savob/data_loading/README.md

# data_loading
Board inspired by the DATA album
