savob/data_loading/hardware/SJ-3523-SMT-TR.step

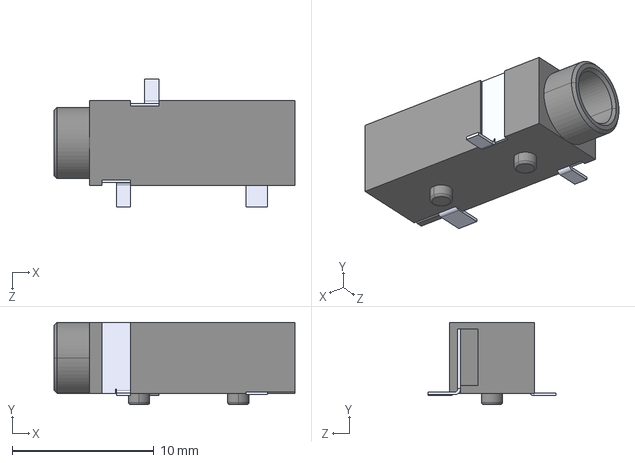
[picture p1: CAD file, 2024-02-17]
hardware/SJ-3523-SMT-TR.step
17.0 x 5.80 x 9.00 mm
