savob/data_loading/hardware/data_rev0/data_rev0.kicad_pcb

## KiCad design hardware/data_rev0/data_rev0.kicad_pcb (2024-03-04, an earlier design)

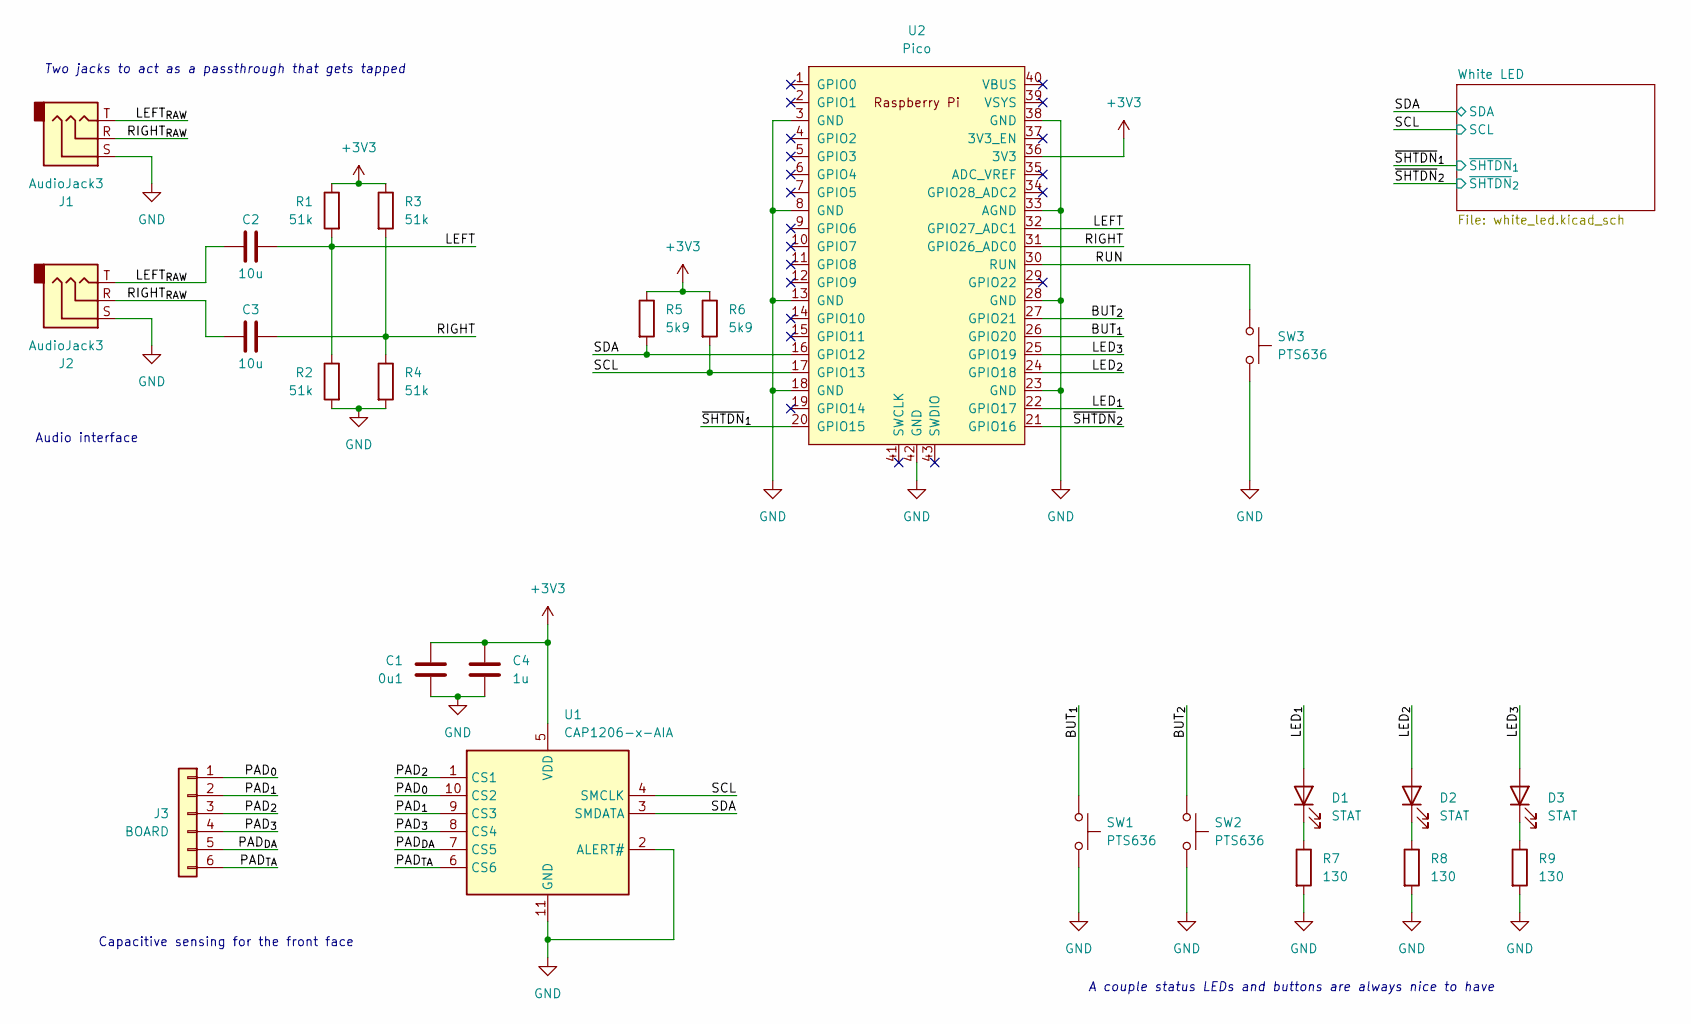
[picture p2: schematic data_rev0.kicad_sch, DATA Loading]

Parts:
C1: 0u1; C_0603_1608Metric
C2, C3: 10u; C_0805_2012Metric
C4: 1u; C_0603_1608Metric
D1, D2, D3: STAT; LED_0805_2012Metric
J1, J2: AudioJack3; Jack_3.5mm_CUI_SJ-3523-SMT_Horizontal
J3: BOARD; fill
R1, R2, R3, R4: 51k; R_0603_1608Metric
R5, R6: 5k9; R_0603_1608Metric
R7, R8, R9: 130; R_0603_1608Metric
SW1, SW2, SW3: PTS636; SW_SPST_CK_RS282G05A3
U1: CAP1206-x-AIA; DFN-10-1EP_3x3mm_P0.5mm_EP1.55x2.48mm
U2: Pico; RPi_Pico_SMD

Connections:
+3V3: C1.1, C4.2, R1.1, R3.1, R5.1, R6.1, U1.5 (VDD), U2.36 (3V3); also elsewhere on the board
/BUT_{1}: SW1.1, U2.26 (GPIO20)
/BUT_{2}: SW2.1, U2.27 (GPIO21)
/LED_{1}: D1.2 (A), U2.22 (GPIO17)
/LED_{2}: D2.2 (A), U2.24 (GPIO18)
/LED_{3}: D3.2 (A), U2.25 (GPIO19)
/LEFT: C2.1, R1.2, R2.1, U2.32 (GPIO27_ADC1)
/LEFT_{RAW}: C2.2, J1.T, J2.T
/PAD_{0}: J3.1, U1.10 (CS2)
/PAD_{1}: J3.2, U1.9 (CS3)
/PAD_{2}: J3.3, U1.1 (CS1)
/PAD_{3}: J3.4, U1.8 (CS4)
/PAD_{DA}: J3.5, U1.7 (CS5)
/PAD_{TA}: J3.6, U1.6 (CS6)
/RIGHT: C3.1, R3.2, R4.1, U2.31 (GPIO26_ADC0)
/RIGHT_{RAW}: C3.2, J1.R, J2.R
/RUN: SW3.1, U2.30 (RUN)
/SCL: R6.2, U1.4 (SMCLK), U2.17 (GPIO13); also elsewhere on the board
/SDA: R5.2, U1.3 (SMDATA), U2.16 (GPIO12); also elsewhere on the board
/~SHTDN_{1}: U2.20 (GPIO15); also elsewhere on the board
/~SHTDN_{2}: U2.21 (GPIO16); also elsewhere on the board
GND: C1.2, C4.1, J1.S, J2.S, R2.2, R4.2, R7.2, R8.2, R9.2, SW1.2, SW2.2, SW3.2, U1.2 (ALERT#), U1.11 (GND), U2.3 (GND), U2.8 (GND), U2.13 (GND), U2.18 (GND), U2.23 (GND), U2.28 (GND), U2.33 (AGND), U2.38 (GND), U2.42 (GND); also elsewhere on the board
unnamed: D1.1 (K), R7.1
unnamed: D2.1 (K), R8.1
unnamed: D3.1 (K), R9.1

Notes on the sheet:
A couple status LEDs and buttons are always nice to have
Two jacks to act as a passthrough that gets tapped
Audio interface
Capacitive sensing for the front face

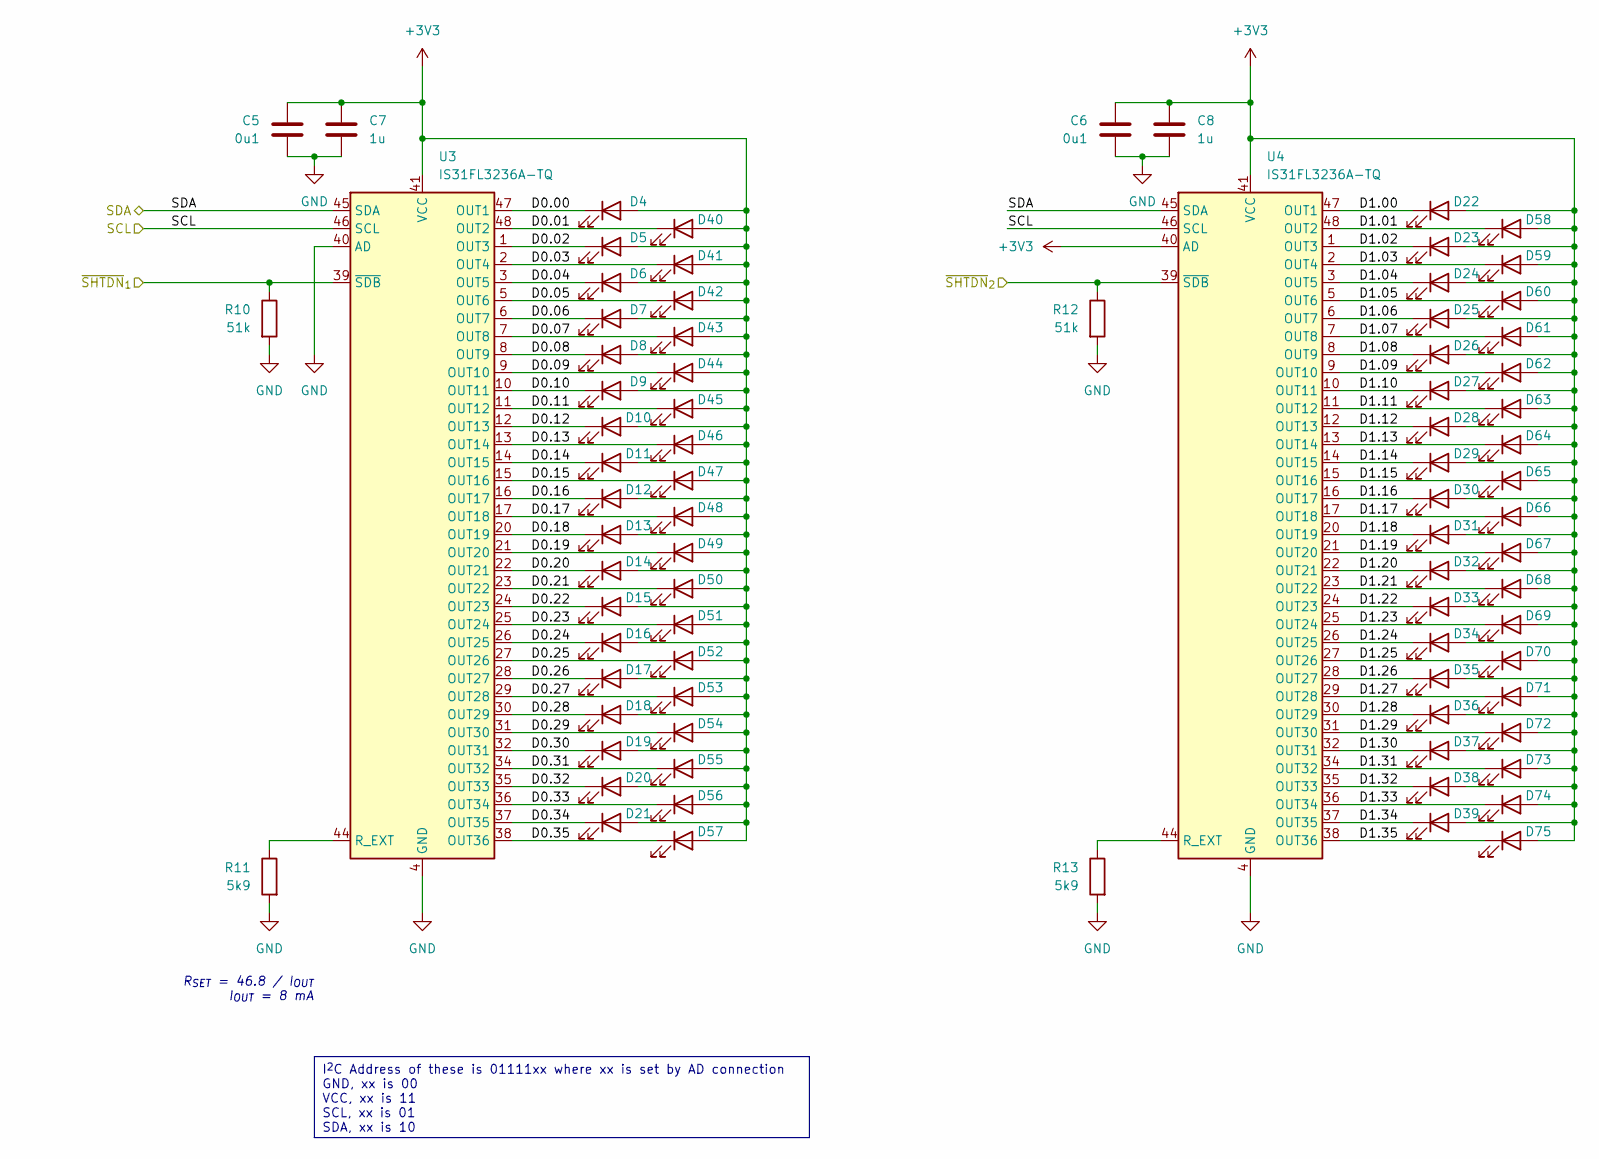
[picture p3: schematic white_led.kicad_sch, White LED Driving]

Parts:
C5, C6: 0u1; C_0603_1608Metric
C7, C8: 1u; C_0603_1608Metric
D4, D5, D6, D7, D8, D9, D10, D11, D12, D13, D14, D15, D16, D17, D18, D19, D20, D21, D22, D23, D24, D25, D26, D27, D28, D29, D30, D31, D32, D33, D34, D35, D36, D37, D38, D39: LED; D_0805_2012Metric
D40, D41, D42, D43, D44, D45, D46, D47, D48, D49, D50, D51, D52, D53, D54, D55, D56, D57, D58, D59, D60, D61, D62, D63, D64, D65, D66, D67, D68, D69, D70, D71, D72, D73, D74, D75: LED_RA; D_1206_3216Metric
R10, R12: 51k; R_0603_1608Metric
R11, R13: 5k9; R_0603_1608Metric
U3, U4: IS31FL3236A-TQ; TQFP-48-1EP_7x7mm_P0.5mm_EP4.11x4.11mm

Connections:
+3V3: C5.1, C6.1, C7.1, C8.1, D4.2 (A), D5.2 (A), D6.2 (A), D7.2 (A), D8.2 (A), D9.2 (A), D10.2 (A), D11.2 (A), D12.2 (A), D13.2 (A), D14.2 (A), D15.2 (A), D16.2 (A), D17.2 (A), D18.2 (A), D19.2 (A), D20.2 (A), D21.2 (A), D22.2 (A), D23.2 (A), D24.2 (A), D25.2 (A), D26.2 (A), D27.2 (A), D28.2 (A), D29.2 (A), D30.2 (A), D31.2 (A), D32.2 (A), D33.2 (A), D34.2 (A), D35.2 (A), D36.2 (A), D37.2 (A), D38.2 (A), D39.2 (A), D40.2 (A), D41.2 (A), D42.2 (A), D43.2 (A), D44.2 (A), D45.2 (A), D46.2 (A), D47.2 (A), D48.2 (A), D49.2 (A), D50.2 (A), D51.2 (A), D52.2 (A), D53.2 (A), D54.2 (A), D55.2 (A), D56.2 (A), D57.2 (A), D58.2 (A), D59.2 (A), D60.2 (A), D61.2 (A), D62.2 (A), D63.2 (A), D64.2 (A), D65.2 (A), D66.2 (A), D67.2 (A), D68.2 (A), D69.2 (A), D70.2 (A), D71.2 (A), D72.2 (A), D73.2 (A), D74.2 (A), D75.2 (A), U3.41 (VCC), U4.40 (AD), U4.41 (VCC); also elsewhere on the board
/SCL: U3.46 (SCL), U4.46 (SCL); also elsewhere on the board
/SDA: U3.45 (SDA), U4.45 (SDA); also elsewhere on the board
/White LED/D0.00: D4.1 (K), U3.47 (OUT1)
/White LED/D0.01: D40.1 (K), U3.48 (OUT2)
/White LED/D0.02: D5.1 (K), U3.1 (OUT3)
/White LED/D0.03: D41.1 (K), U3.2 (OUT4)
/White LED/D0.04: D6.1 (K), U3.3 (OUT5)
/White LED/D0.05: D42.1 (K), U3.5 (OUT6)
/White LED/D0.06: D7.1 (K), U3.6 (OUT7)
/White LED/D0.07: D43.1 (K), U3.7 (OUT8)
/White LED/D0.08: D8.1 (K), U3.8 (OUT9)
/White LED/D0.09: D44.1 (K), U3.9 (OUT10)
/White LED/D0.10: D9.1 (K), U3.10 (OUT11)
/White LED/D0.11: D45.1 (K), U3.11 (OUT12)
/White LED/D0.12: D10.1 (K), U3.12 (OUT13)
/White LED/D0.13: D46.1 (K), U3.13 (OUT14)
/White LED/D0.14: D11.1 (K), U3.14 (OUT15)
/White LED/D0.15: D47.1 (K), U3.15 (OUT16)
/White LED/D0.16: D12.1 (K), U3.16 (OUT17)
/White LED/D0.17: D48.1 (K), U3.17 (OUT18)
/White LED/D0.18: D13.1 (K), U3.20 (OUT19)
/White LED/D0.19: D49.1 (K), U3.21 (OUT20)
/White LED/D0.20: D14.1 (K), U3.22 (OUT21)
/White LED/D0.21: D50.1 (K), U3.23 (OUT22)
/White LED/D0.22: D15.1 (K), U3.24 (OUT23)
/White LED/D0.23: D51.1 (K), U3.25 (OUT24)
/White LED/D0.24: D16.1 (K), U3.26 (OUT25)
/White LED/D0.25: D52.1 (K), U3.27 (OUT26)
/White LED/D0.26: D17.1 (K), U3.28 (OUT27)
/White LED/D0.27: D53.1 (K), U3.29 (OUT28)
/White LED/D0.28: D18.1 (K), U3.30 (OUT29)
/White LED/D0.29: D54.1 (K), U3.31 (OUT30)
/White LED/D0.30: D19.1 (K), U3.32 (OUT31)
/White LED/D0.31: D55.1 (K), U3.34 (OUT32)
/White LED/D0.32: D20.1 (K), U3.35 (OUT33)
/White LED/D0.33: D56.1 (K), U3.36 (OUT34)
/White LED/D0.34: D21.1 (K), U3.37 (OUT35)
/White LED/D0.35: D57.1 (K), U3.38 (OUT36)
/White LED/D1.00: D22.1 (K), U4.47 (OUT1)
/White LED/D1.01: D58.1 (K), U4.48 (OUT2)
/White LED/D1.02: D23.1 (K), U4.1 (OUT3)
/White LED/D1.03: D59.1 (K), U4.2 (OUT4)
/White LED/D1.04: D24.1 (K), U4.3 (OUT5)
/White LED/D1.05: D60.1 (K), U4.5 (OUT6)
/White LED/D1.06: D25.1 (K), U4.6 (OUT7)
/White LED/D1.07: D61.1 (K), U4.7 (OUT8)
/White LED/D1.08: D26.1 (K), U4.8 (OUT9)
/White LED/D1.09: D62.1 (K), U4.9 (OUT10)
/White LED/D1.10: D27.1 (K), U4.10 (OUT11)
/White LED/D1.11: D63.1 (K), U4.11 (OUT12)
/White LED/D1.12: D28.1 (K), U4.12 (OUT13)
/White LED/D1.13: D64.1 (K), U4.13 (OUT14)
/White LED/D1.14: D29.1 (K), U4.14 (OUT15)
/White LED/D1.15: D65.1 (K), U4.15 (OUT16)
/White LED/D1.16: D30.1 (K), U4.16 (OUT17)
/White LED/D1.17: D66.1 (K), U4.17 (OUT18)
/White LED/D1.18: D31.1 (K), U4.20 (OUT19)
/White LED/D1.19: D67.1 (K), U4.21 (OUT20)
/White LED/D1.20: D32.1 (K), U4.22 (OUT21)
/White LED/D1.21: D68.1 (K), U4.23 (OUT22)
/White LED/D1.22: D33.1 (K), U4.24 (OUT23)
/White LED/D1.23: D69.1 (K), U4.25 (OUT24)
/White LED/D1.24: D34.1 (K), U4.26 (OUT25)
/White LED/D1.25: D70.1 (K), U4.27 (OUT26)
/White LED/D1.26: D35.1 (K), U4.28 (OUT27)
/White LED/D1.27: D71.1 (K), U4.29 (OUT28)
/White LED/D1.28: D36.1 (K), U4.30 (OUT29)
/White LED/D1.29: D72.1 (K), U4.31 (OUT30)
/White LED/D1.30: D37.1 (K), U4.32 (OUT31)
/White LED/D1.31: D73.1 (K), U4.34 (OUT32)
/White LED/D1.32: D38.1 (K), U4.35 (OUT33)
/White LED/D1.33: D74.1 (K), U4.36 (OUT34)
/White LED/D1.34: D39.1 (K), U4.37 (OUT35)
/White LED/D1.35: D75.1 (K), U4.38 (OUT36)
/~SHTDN_{1}: R10.1, U3.39 (~SDB); also elsewhere on the board
/~SHTDN_{2}: R12.1, U4.39 (~SDB); also elsewhere on the board
GND: C5.2, C6.2, C7.2, C8.2, R10.2, R11.2, R12.2, R13.2, U3.4 (GND), U3.18 (GND), U3.19 (GND), U3.33 (GND), U3.40 (AD), U3.42 (GND), U3.43 (GND), U3.49 (GND), U4.4 (GND), U4.18 (GND), U4.19 (GND), U4.33 (GND), U4.42 (GND), U4.43 (GND), U4.49 (GND); also elsewhere on the board
unnamed: R11.1, U3.44 (R_EXT)
unnamed: R13.1, U4.44 (R_EXT)

Notes on the sheet:
I^{2}C Address of these is 01111xx where xx is set by AD connection GND, xx is 00 VCC, xx is 11 SCL, xx is 01 SDA, xx is 10
R_{SET} = 46.8 / I_{OUT} I_{OUT} = 8 mA

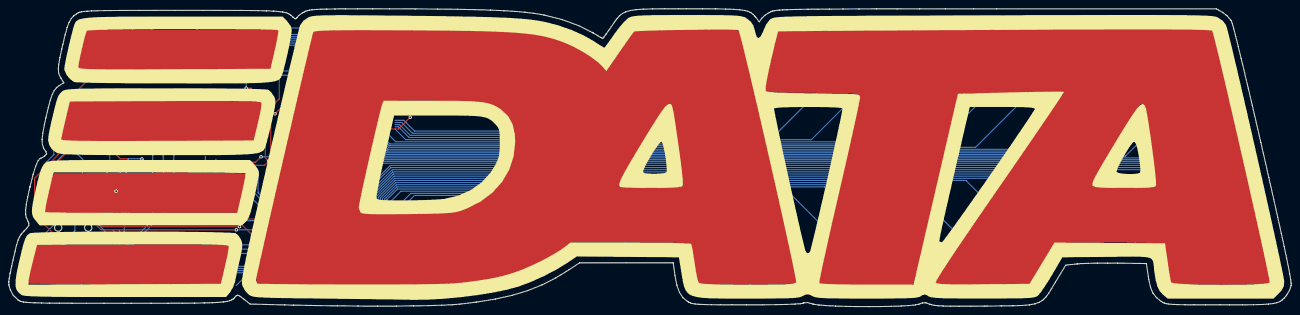
[picture p4: board data_rev0.kicad_pcb from above]

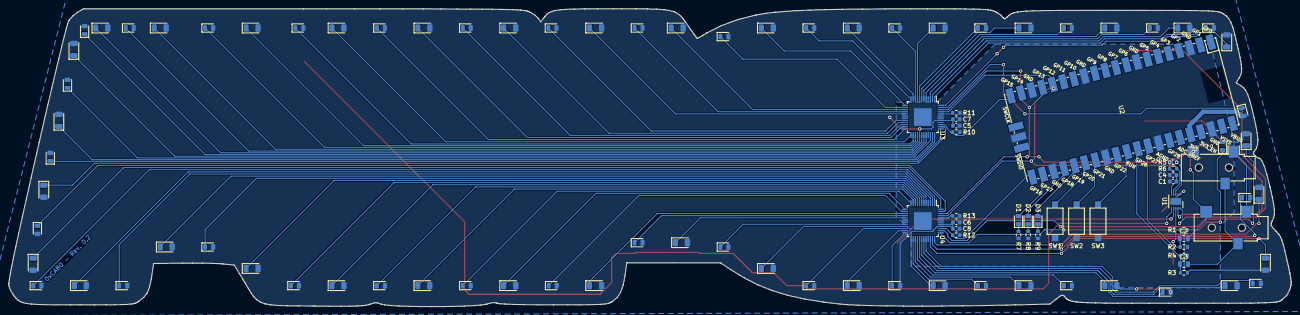
[picture p5: board data_rev0.kicad_pcb from below]

Board: 2 copper layers, 298.7 x 69.4 mm, 106 parts (105 on the bottom side), 99 nets.
