savob/data_loading/(commit log)

2024-02-15 Initialization of hardware project
    [data_rev1.kicad_pcb, data_rev1.kicad_sch]
2024-02-15 Added subsheets for rev 1
    [audio.kicad_sch, data_rev1.kicad_sch, power.kicad_sch, white_led.kicad_sch]
2024-02-17 Initial layout and circuit
    [SJ-3523-SMT-TR.step, audio.kicad_sch, data_rev1.kicad_pcb, data_rev1.kicad_sch, white_led.kicad_sch]
2024-02-17 Moved audio jacks to the side. Ordered.
    [data_rev1.kicad_pcb, data_rev1.kicad_sch]
2024-02-17 Added ordered gerber filed
2024-02-17 Changed name of gerber archive
2024-02-19 Upped the IC revision for the LED driver to IS31FL3236*A*
    [data_rev1.kicad_pcb, power.kicad_sch, white_led.kicad_sch]
2024-02-19 Finalized BOM
    [data_rev1.kicad_pcb, data_rev1.kicad_sch, white_led.kicad_sch]
2024-02-22 Started firmware project
    Lightly modified code for an RPi Pico spectrum analyzer http://radiopench.blog96.fc2.com/. Stripped out the code related to running it's display.
2024-02-22 Added address note for LED drivers
    [white_led.kicad_sch]
2024-02-22 Initial LED driver library
2024-02-22 Initial touch sensor library
2024-02-23 Added labels for LED lines
    [data_rev1.kicad_pcb, white_led.kicad_sch]
2024-02-23 Initial LED library
    Also moved gamma constants fromm drivers to LED calculation
2024-02-23 Touched up initial LED committed
    Shifted from specifying the step period for effect to the overall period so they're easier to tune.
    Added `typedef`s for easier optimization later.
2024-02-23 Added LED helper functions
2024-02-25 Added wave LED effects
2024-02-26 Touch ups
    Lots of small changes and fixes:
    - Fixed when `nextMark` is updated so resets can actually be detected
    - Added an `if` statement for noticing changing states in the FSM
    - Fixed some comments
    - Added helper functions/variables for gamma-corrected LED level operation
2024-02-26 Added tracking to LED FSM
2024-02-26 Added LED FSM to main loop
2024-02-27 Fixed LED driver addresses
    [white_led.kicad_sch]
2024-02-27 Working CAP1206 committed
    Made several small fixes that contributed to the CAP1206 now working:
    - Read transactions should not be stopped after register address write
    - Added additional error checking for I2C transfers
    - Autoclear interrupt flag for CAP on reads so the sensors would detect release
    - Added functions for checking device characteristics (ID, Manufacturer, Rev). *Useful for tests.*
    - Added `readDelta` function
    - Added `setMultiTouchConfig` function to control that portion
    - Adjusted some initialization parameters from tests
2024-02-27 Moved to KiCad 8.0.0
    Also added value for right angle LEDs toi be seperate of the head on ones
    [data_rev1.kicad_pcb, data_rev1.kicad_sch, white_led.kicad_sch]
2024-02-28 Excluded most parts from simulation
    [data_rev1.kicad_sch, white_led.kicad_sch]
2024-02-28 Initial audio driver
2024-02-29 Got wave effects working
    Touched up reset function to account for audio sampling time to prevent continuous resets if the audio sampling takes much longer than the function is meant to run.
    Also changed LED constants to all caps to make them clear in the code.
    [main.cpp]
2024-02-29 Added interrupt check for pads
    This way single and repeat events are properly picked up.
    Also broke long lines in the CAP1206 library.
    [main.cpp]
2024-03-01 Added LED rotation function
    Also refactored code for LEDs a bit and the moved the defaults for functions to the `.hpp`
2024-03-01 Bump LED effect complete
2024-03-01 Integrated capacitive pads for LED FSM control
    Had to rework some of the logic for the CAP sensor to avoid recording release events.
    [main.cpp]
2024-03-01 Improved LED gamma system
    Main intent was to improve the colour inversion. Also merged `uniformLED` and `uniformGamma` for easier maintenance.
2024-03-01 Improved rcolumn/row painting functions
    There was an indexing error in the row painting for LED[0].
    Changed their logic to use an generic pointer so updating the same logic for different faces applies to both gamma and brightness.
2024-03-01 Added balance LED effect
2024-03-01 Fixed `filterSpectrum` reading out of bounds
2024-03-04 Proper LED driver setup
2024-03-04 Changed SOLID LED to allow brightness control
2024-03-04 Removed redundant driver initialization
2024-03-04 Added Rev 0 project
    Started some of my changes on Rev 1. Also changed the RP Pico footprint to have solderpaste on the pads.
    [data_rev0.kicad_pcb, data_rev0.kicad_sch, white_led.kicad_sch]
2024-03-04 Changed LED to use only gamma levels
    This was done to simplify code and make it easier for proper inversion to be done.
2024-03-05 Moved sample preprocessing to sampling block
2024-03-05 Added check to see if LED updates were necessary
    Might try to make it smarter in the future to specifically target regiseters if only a couple need changing instead of writing the entire buffer.
2024-03-10 Added forced update of LED duties on initialization
2024-03-10 Added watchdog timer feature
2024-03-10 Adjusted touch sensitivity
    Adjusted capacitive sensing senisitivity so it wasn't saturating, needed to be stepped down by a factor of 16!
    Now a finger press is about 70 to 75. Should be much more resistant to noise/interference from other circuitry.
    Also fixed the `readDelta` function to properly read the deltas as signed values.
2024-03-15 Added ability to ignore bottom frequencies
    Since the bottom frequency buckets generally hold non-zero values due to DC components in the FFT they messed up the visuals by always being on.
2024-03-15 Made `SerialUSB` explicit
    Also fixed minor spelling error for shifting enumerator
    [main.cpp]
2024-03-15 Added periodic capacitive sensor recalibration in inactivity
2024-03-15 Added delay to non-audio loops
    This seems to make the contact pads/capacitive system more responsive in non-audio modes.
    Probably due to the contact sensor being continuously pooled since Rev. 0 doesn't use its interrupt pin.
    [main.cpp]
2024-03-15 Changed touch sensor to be periodically polled
    This is better for the LED effects compared to a delay for each loop cycle
2024-03-18 Reworked audio sample control
    Allow for more granular audio processing increments. Some modes need none, others just RMS and then few the actual spectrum which takes a lot of time to aquire.
    [main.cpp]
